PhilopatearSalib/automated-component-inspection/hardware/cad/Lower_Fixation_P1.stl

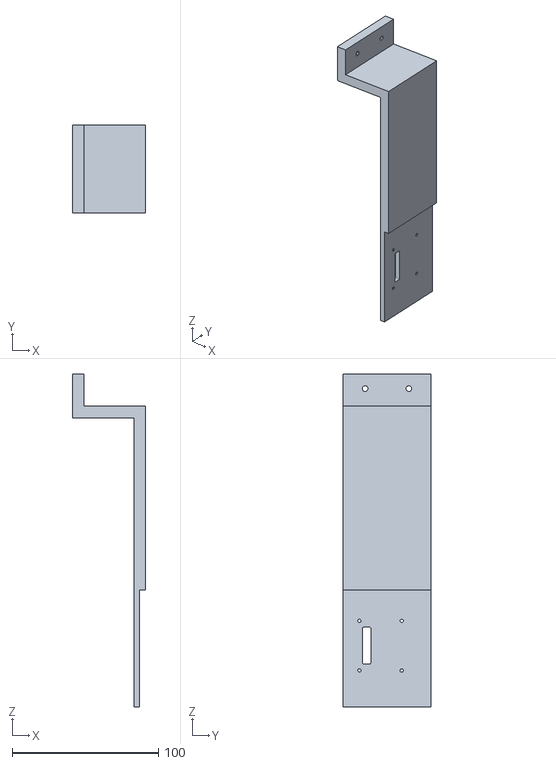
[picture p9: CAD file, 2026-10-14]
hardware/cad/Lower_Fixation_P1.stl
50.0 x 60.0 x 228.0
