PhilopatearSalib/automated-component-inspection/hardware/cad/Upper_Fixation_P2.stl

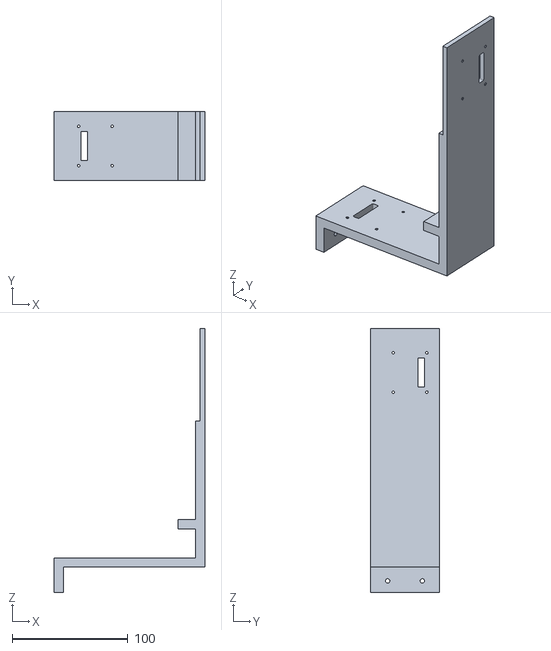
[picture p10: CAD file, 2026-10-14]
hardware/cad/Upper_Fixation_P2.stl
130.0 x 60.0 x 228.0
