PhilopatearSalib/automated-component-inspection/(list of files, cad)

Other CAD files:
hardware/cad/Upper_Fixation_P1.stl
hardware/cad/Lower_Fixation_P2.stl
