PhilopatearSalib/automated-component-inspection/(commit log)

2024-05-27 State of the project at thesis publication
    ResNet-34/50/101/152 training scripts, the 16-class test script and the
    Raspberry Pi capture and real-time inspection scripts. Their exact save
    dates were not preserved, so this commit is dated to the thesis
    publication date (27 May 2024), by which point they all existed.
2026-10-14 Rewrite, document and publish the project
    Restructures the original scripts into matlab/, python/ and pi/, fixes
    their bugs, and adds the README, retraining guide, figures and the
    camera mount STL files. The original scripts remain under the
    v2024-thesis tag.
    [Lower_Fixation_P1.stl, Lower_Fixation_P2.stl, Upper_Fixation_P1.stl, Upper_Fixation_P2.stl]
